LGsekara1/Multi-channel-RF-level-detector/README.md

# Multilevel RF Power Detector
**Dual-Band 433 MHz / 915 MHz RF Presence Indicator**

---

## General Description

The **Multilevel RF Power Detector** is a compact dual-band RF sensing device designed to detect and visually indicate the relative power of radio-frequency signals in the **433 MHz** and **915 MHz** ISM bands. The system employs band-pass filtering, low-noise amplification, and logarithmic detection to provide reliable RF presence indication using a multi-level LED display.

The device is intended for educational, laboratory, and experimental RF applications where quick visual feedback is required without the use of complex RF measurement equipment.

---

## Key Features

- Dual-band RF detection: 433 MHz and 915 MHz
- Logarithmic RF power detection
- Multi-level LED signal strength indication
- RF-optimized PCB layout
- Single DC supply operation
- Compact and portable design

---

## Applications

- ISM band signal monitoring
- RF laboratory demonstrations
- Educational RF experiments
- RF activity detection
- Wireless system debugging

---

## Functional Block Diagram

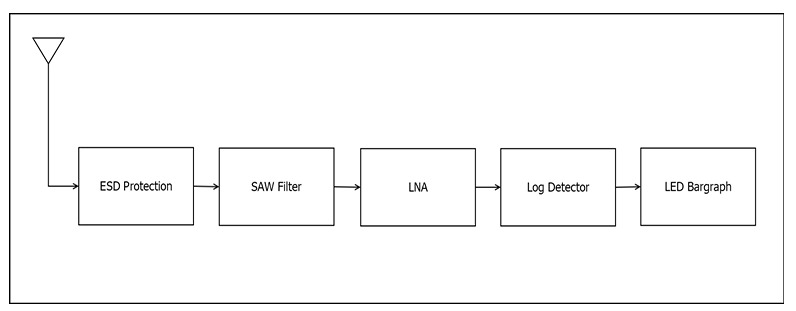
[picture p1: media/schematic_page18.jpg]
Block Diagram


---

## Electrical Characteristics

| Parameter | Typical Value |
|---|---|
| Supported Frequency Bands | 433 MHz, 915 MHz |
| Input Impedance | 50 Ω |
| LNA Gain | 433 MHz: 20.3 dB<br>915 MHz: 17.9 dB |
| Noise Figure | 433 MHz: 2.3 dB<br>915 MHz: 2.8 dB |
| Supply Voltage (Nominal) | 9 V |
| Supply Current | 200 mA |

---

## LED Signal Indication

| LED Status | RF Power Level (Relative) |
|---|---|
| 1 LED ON | Very Low |
| 2–3 LEDs ON | Low to Medium |
| 4–5 LEDs ON | Medium to High |
| All LEDs ON | High RF Power |

---

## Power Supply

- Single DC supply operation
- On-board voltage regulation

---

## Mechanical Information

| Parameter | Specification |
|---|---|
| PCB Dimensions | 126.37 mm × 129 mm |
| Antenna Connector | SMA Edge-Mount |
| Enclosure | Custom Enclosure |

---

## Mechanical Drawings

**Mechanical Drawing – Page 1**  
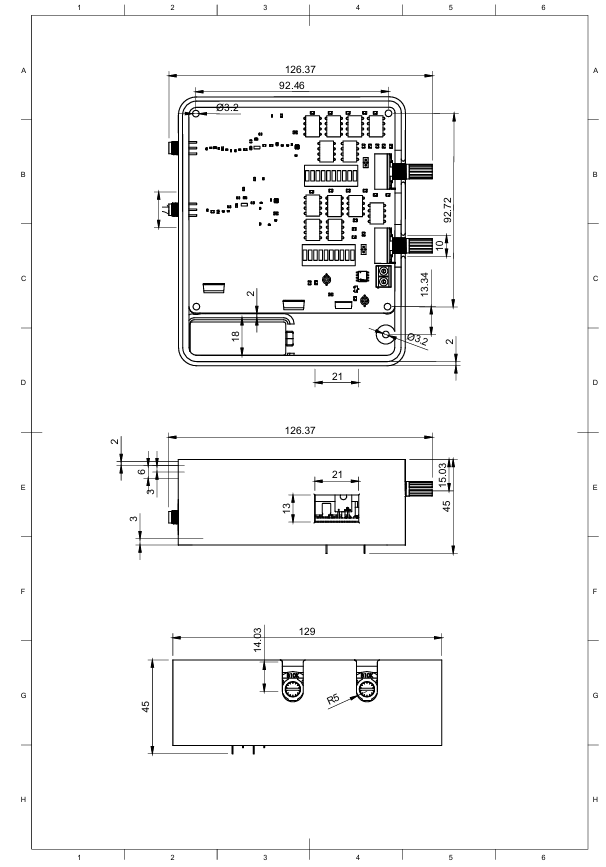
[picture p2: media/AnalogProject-page1.png]
Mechanical Drawing Page 1


**Mechanical Drawing – Page 2 (Assembly Views)**  
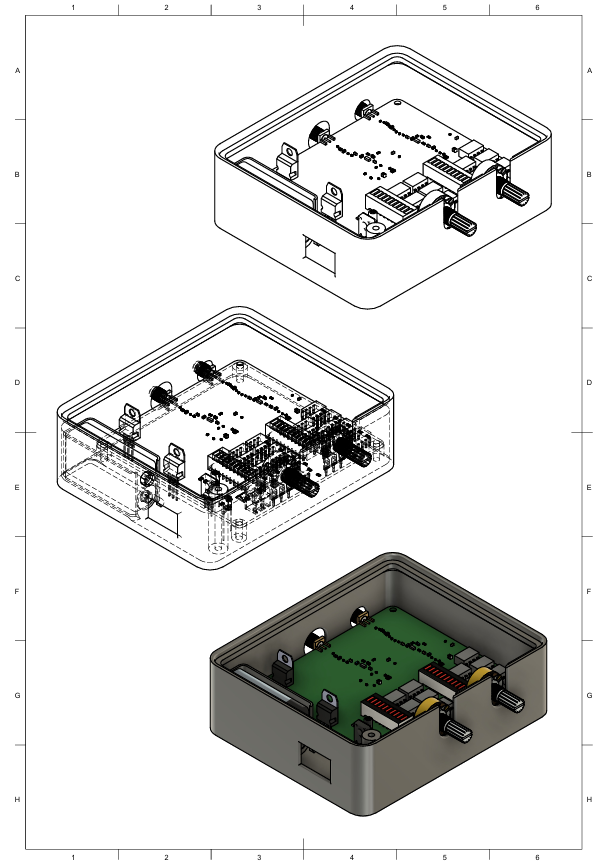
[picture p3: media/AnalogProject-page2.png]
Mechanical Drawing Page 2


---

## Schematics

### 433 MHz Section
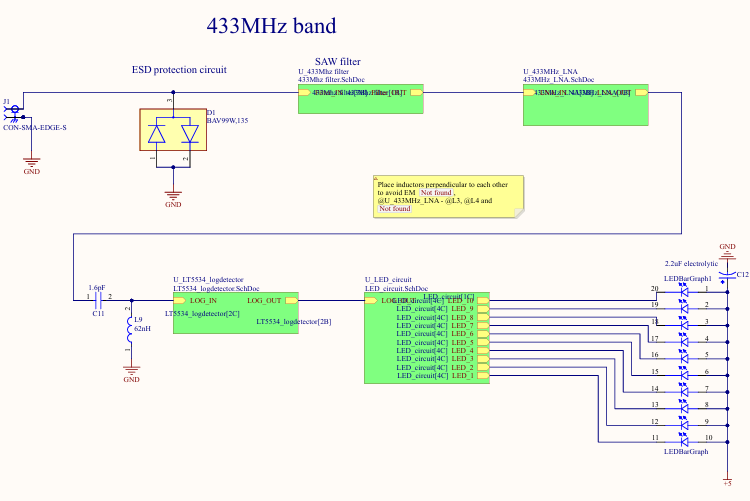
[picture p4: media/schematic_page1.png]
433 MHz Schematic


### 433 MHz LNA Design
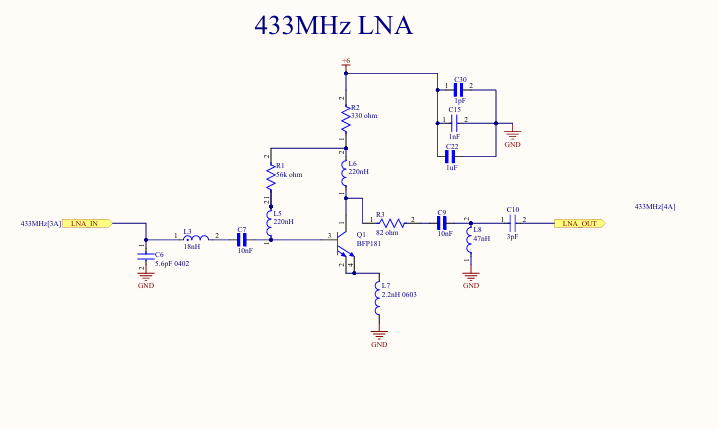
[picture p5: media/schematic_page2.png]
433 MHz LNA


### LED Driver Circuit
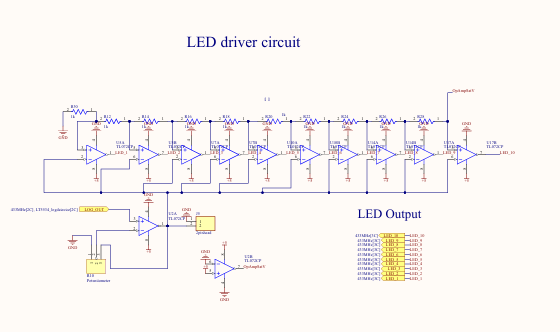
[picture p6: media/schematic_page3.png]
LED Driver


### Log Detector Circuit
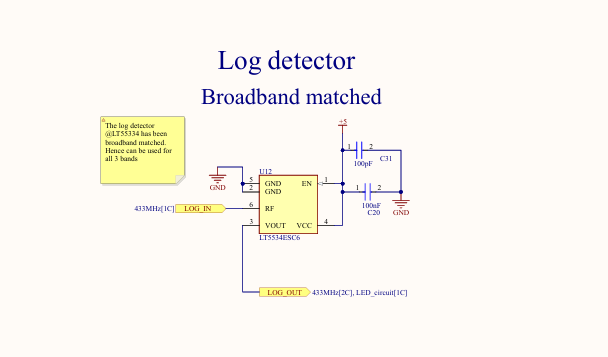
[picture p7: media/schematic_page4.png]
Log Detector


### 433 MHz Band-Pass Filter
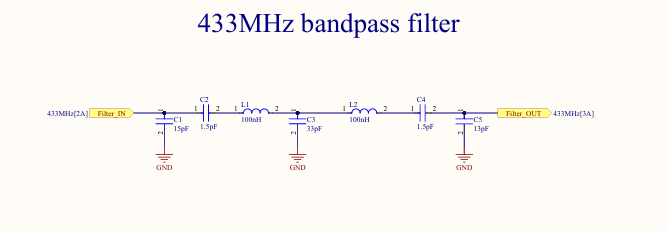
[picture p8: media/schematic_page5.png]
433 MHz BPF


### 915 MHz Section
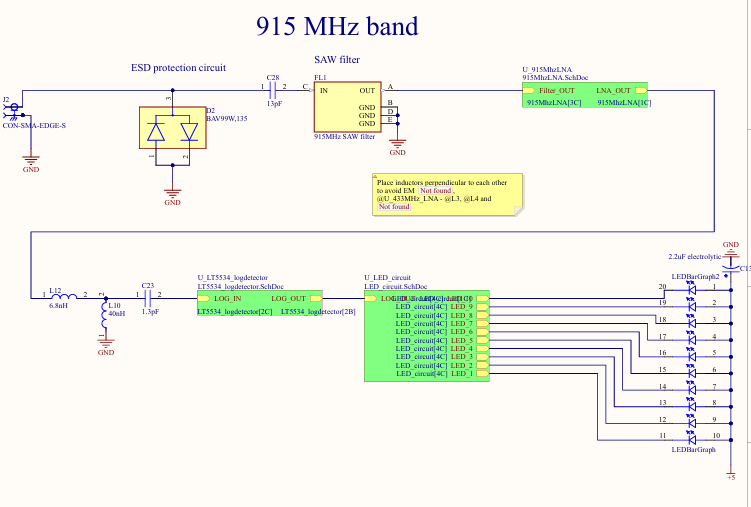
[picture p9: media/schematic_page6.png]
915 MHz Schematic


### 915 MHz LNA Design
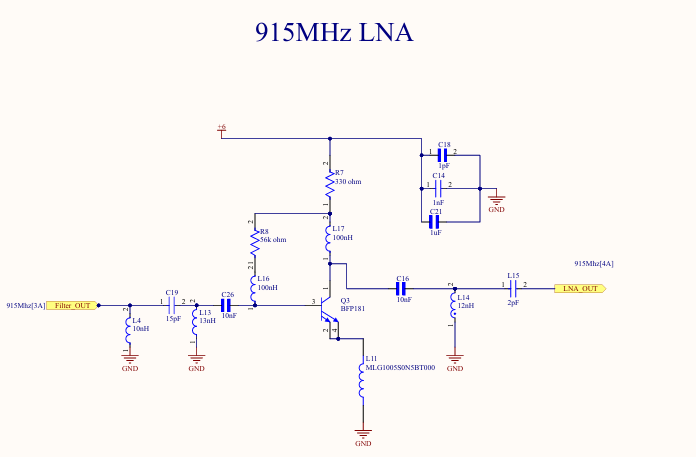
[picture p10: media/schematic_page7.png]
915 MHz LNA


### Power Supply Design
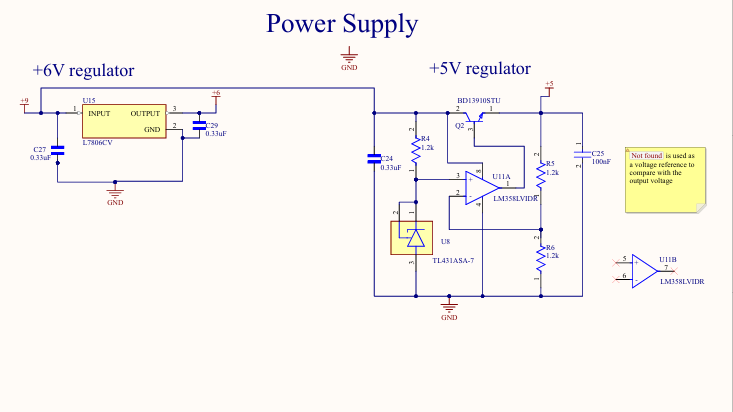
[picture p11: media/schematic_page8.png]
Power Supply


The power supply contains a 5V and 6V stable power supply. The 6V power supply being a 7806 regulator IC as the LNA requires a firm supply voltage. And the 5V supply was designed with a series transitor with a feedback with a TL431 as the reference voltage. This formation was selected because, the negative feedback maintains a relatively stable output of 5V and heat generation is minimum due to less current through series resistor in input branch.

---

## PCB Layout

### Top Layer
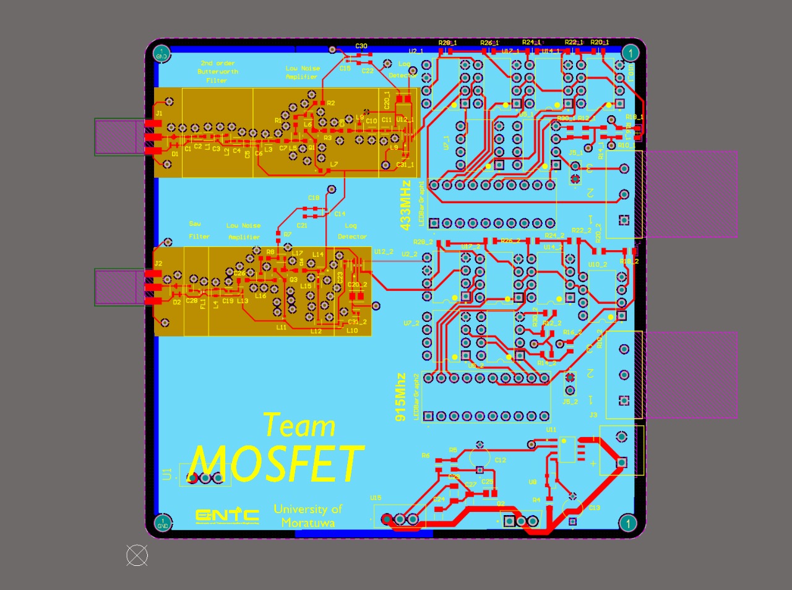
[picture p12: media/schematic_page9.jpg]
Top Layer


### RF Ground Layer (Layer 2)
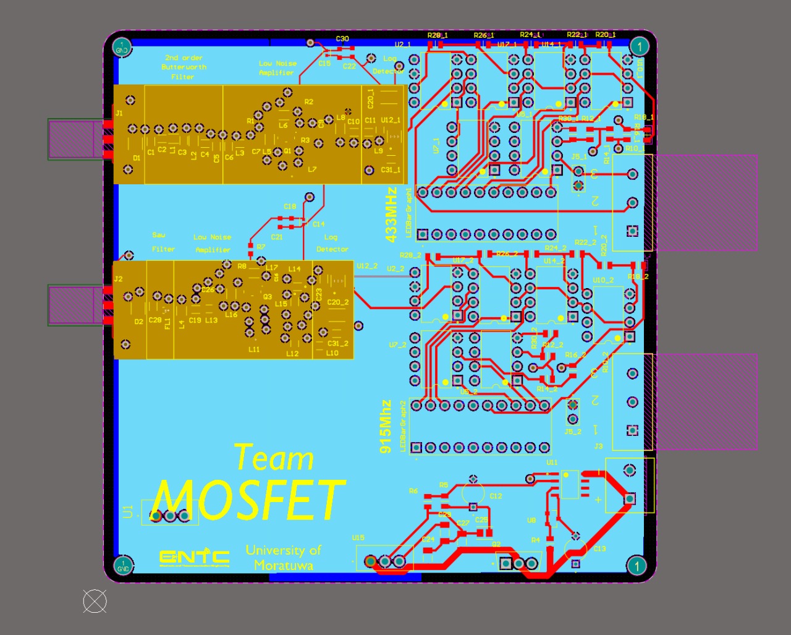
[picture p13: media/schematic_page14.jpg]
RF GND Layer


### PCB Ground Layer (Layer 3)
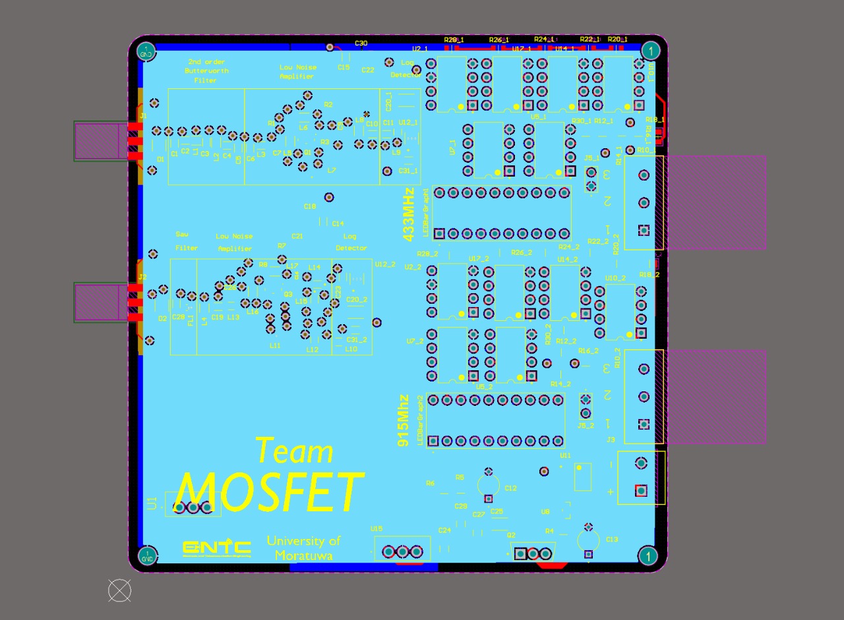
[picture p14: media/schematic_page10.jpg]
PCB GND Layer


### Bottom Layer
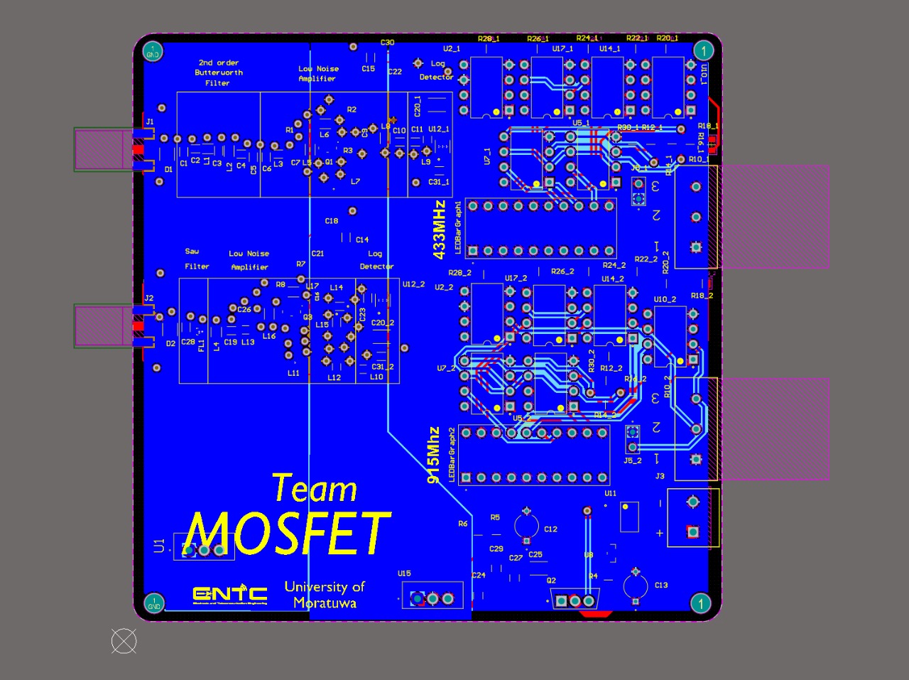
[picture p15: media/schematic_page11.jpg]
Bottom Layer


### PCB Stack-Up
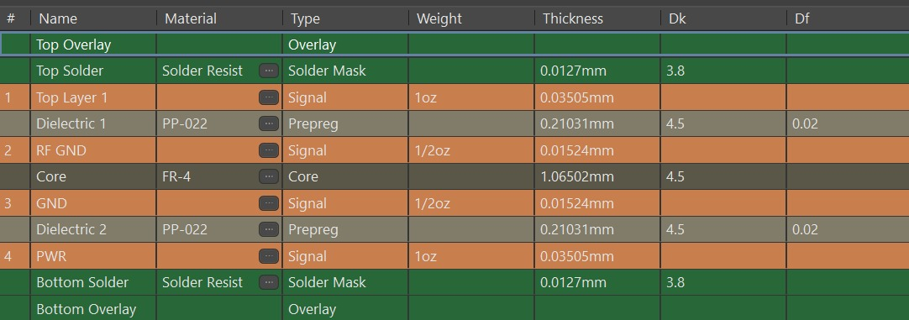
[picture p16: media/schematic_page12.jpg]
PCB Stackup


### 3D PCB View
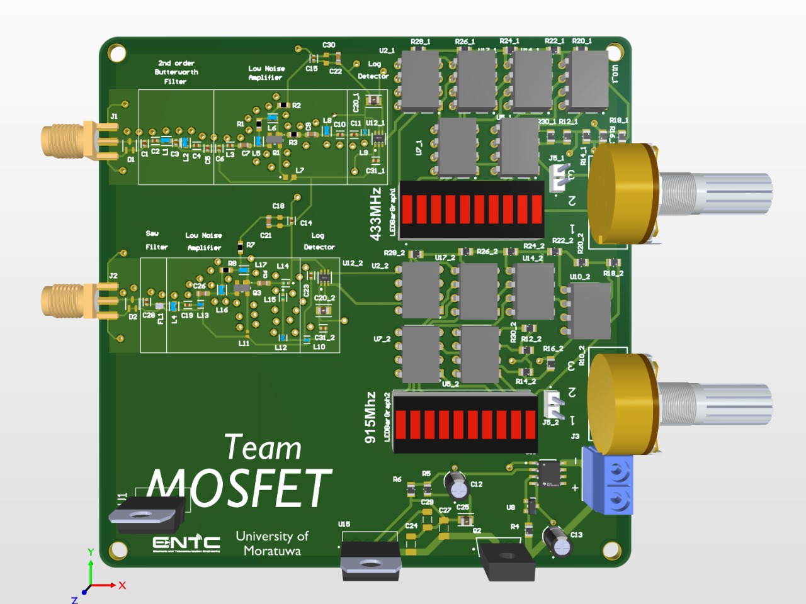
[picture p17: media/schematic_page13.jpg]
3D View


---

## Frequency Response

### 433 MHz Band
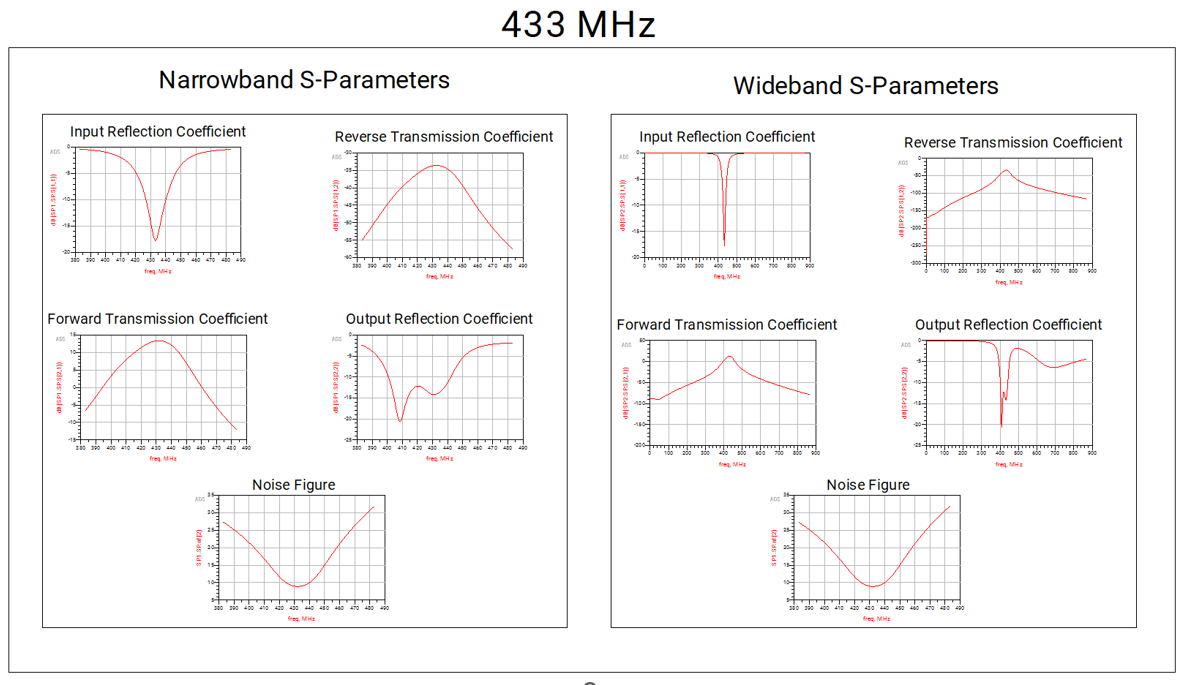
[picture p18: media/schematic_page15.png]
433 MHz Response


### 915 MHz Band
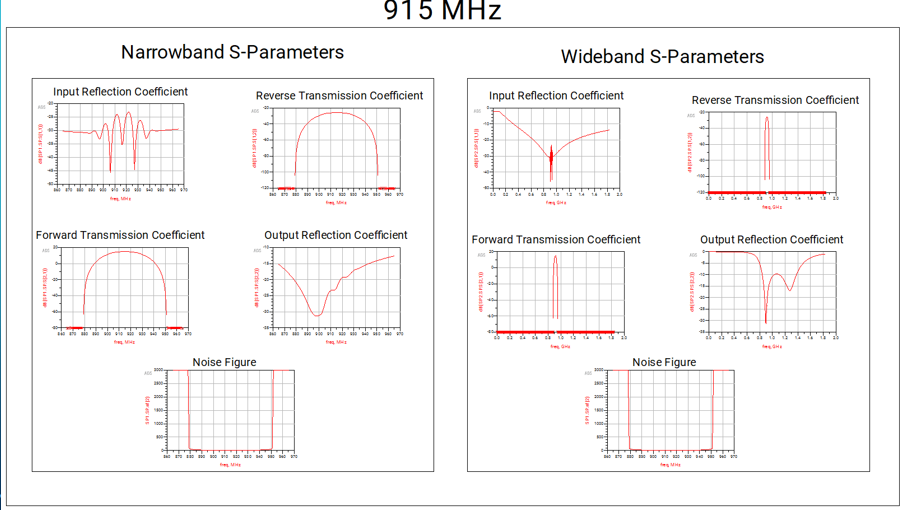
[picture p19: media/schematic_page16.png]
915 MHz Response


---

## Final Product

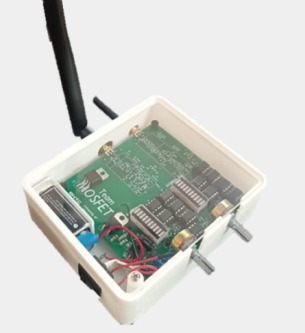
[picture p20: media/schematic_page17.jpg]
Final Product


---

## Team MOSFET
The project is developed and maintained by;
  1. Lakindu Gunasekara [@LGsekara1](https://github.com/LGsekara1)
  2. Sithum Peiris [@angstrom10](https://github.com/angstrom10)
  3. Hiruna Kariyawasam [@HirunaK](https://github.com/HirunaK)
  4. Chathuka Elapatha [@Chippy1520](https://github.com/Chippy1520)

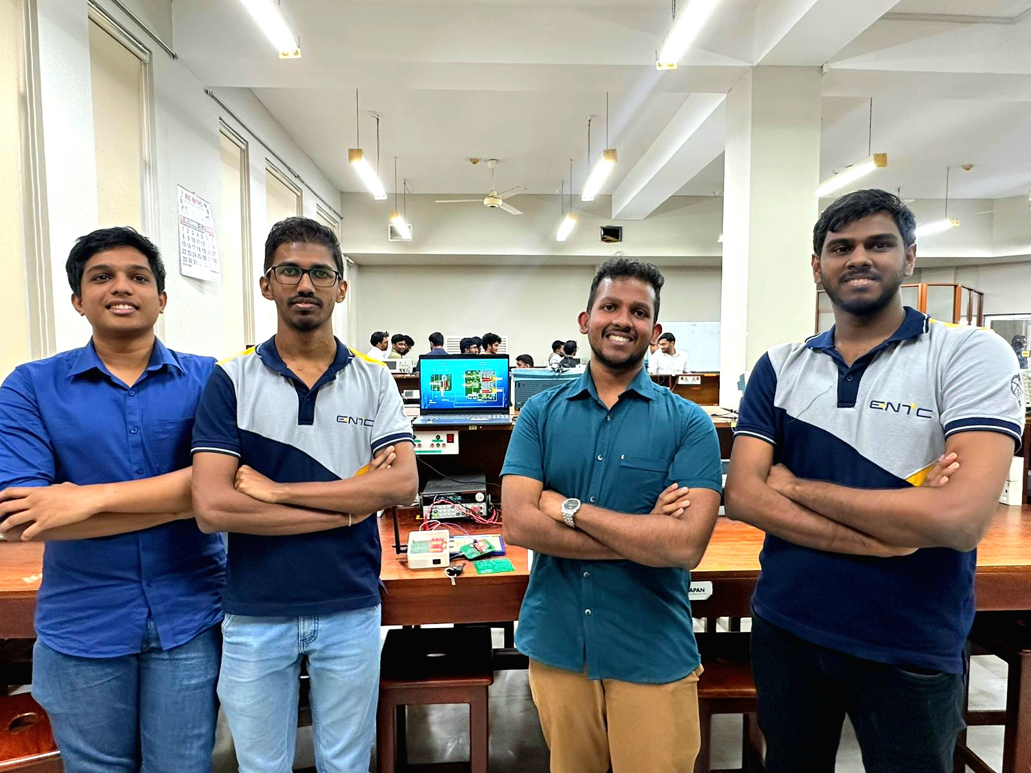
[picture p21: media/Team.jpg]
Team


## Handling and Precautions

- Device contains ESD-sensitive RF components
- Avoid hot-plugging the antenna
- Do not exceed the maximum supply voltage
- Use only matched SMA antennas

---

## Disclaimer

This product is intended for educational and experimental use only. It is not a calibrated RF power measurement instrument. Specifications are subject to change without notice.

---

**Department of Electronic & Telecommunication Engineering**  
**University of Moratuwa, Sri Lanka**
