LGsekara1/Multi-channel-RF-level-detector/media/433LNA_sim.png

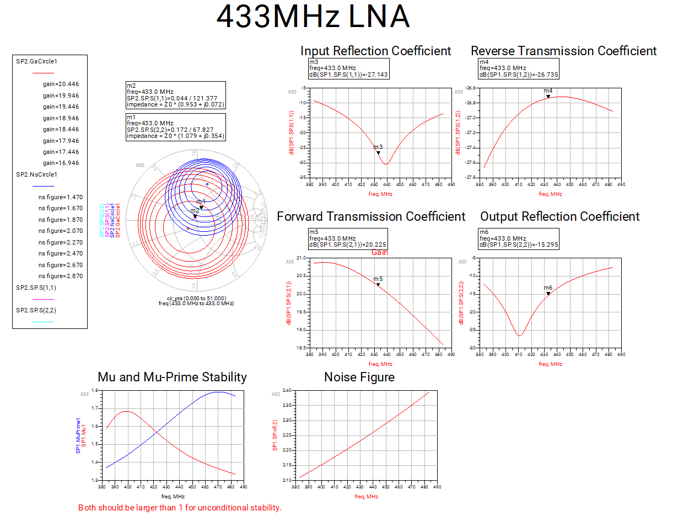
media/433LNA_sim.png
