LGsekara1/Multi-channel-RF-level-detector/media/433MHz LC filter.png

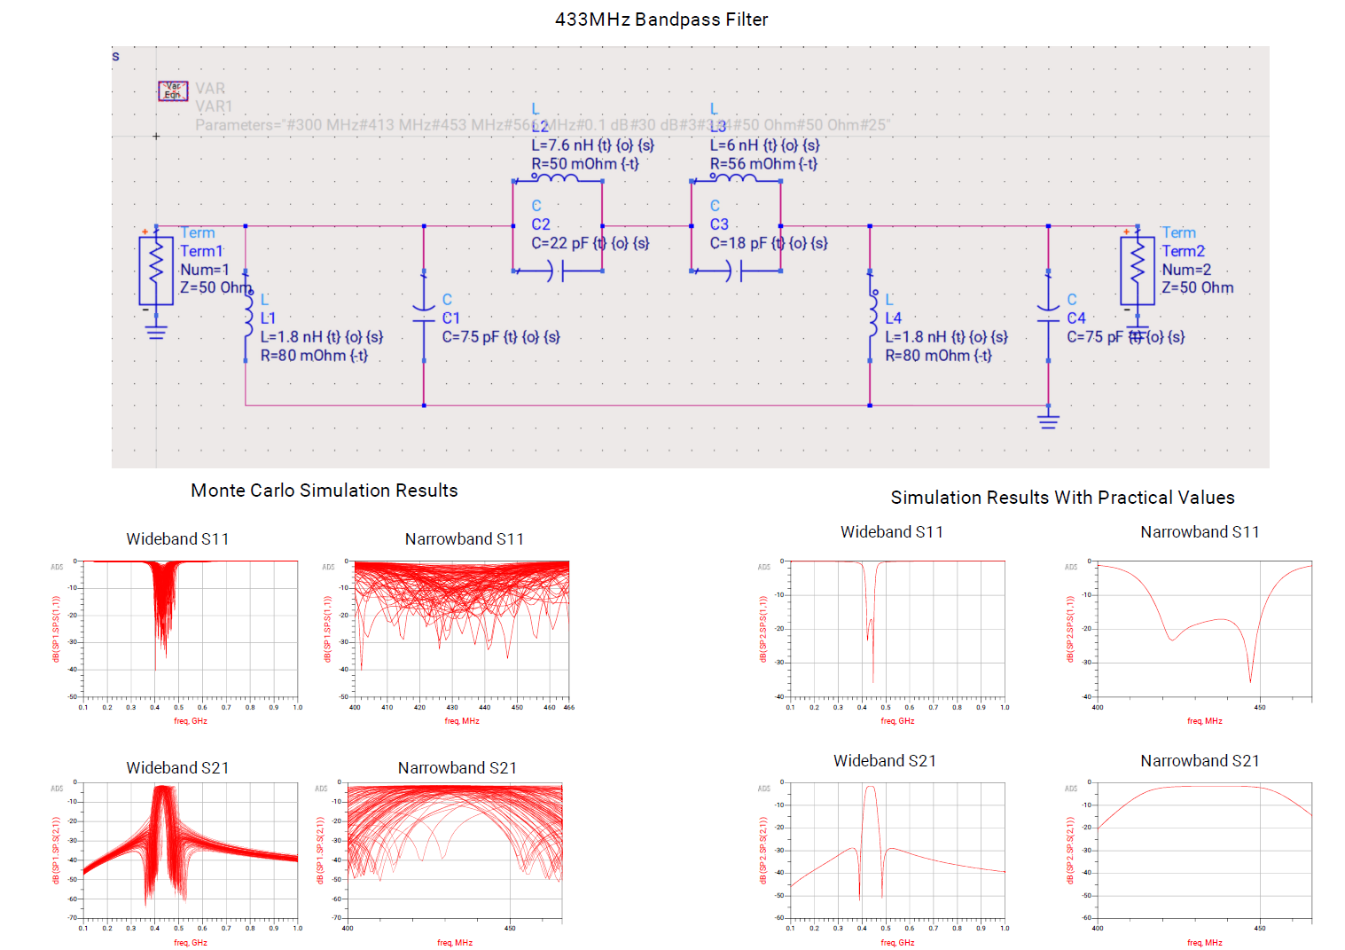
media/433MHz LC filter.png
