LGsekara1/Multi-channel-RF-level-detector/media/915LNA_Sim.png

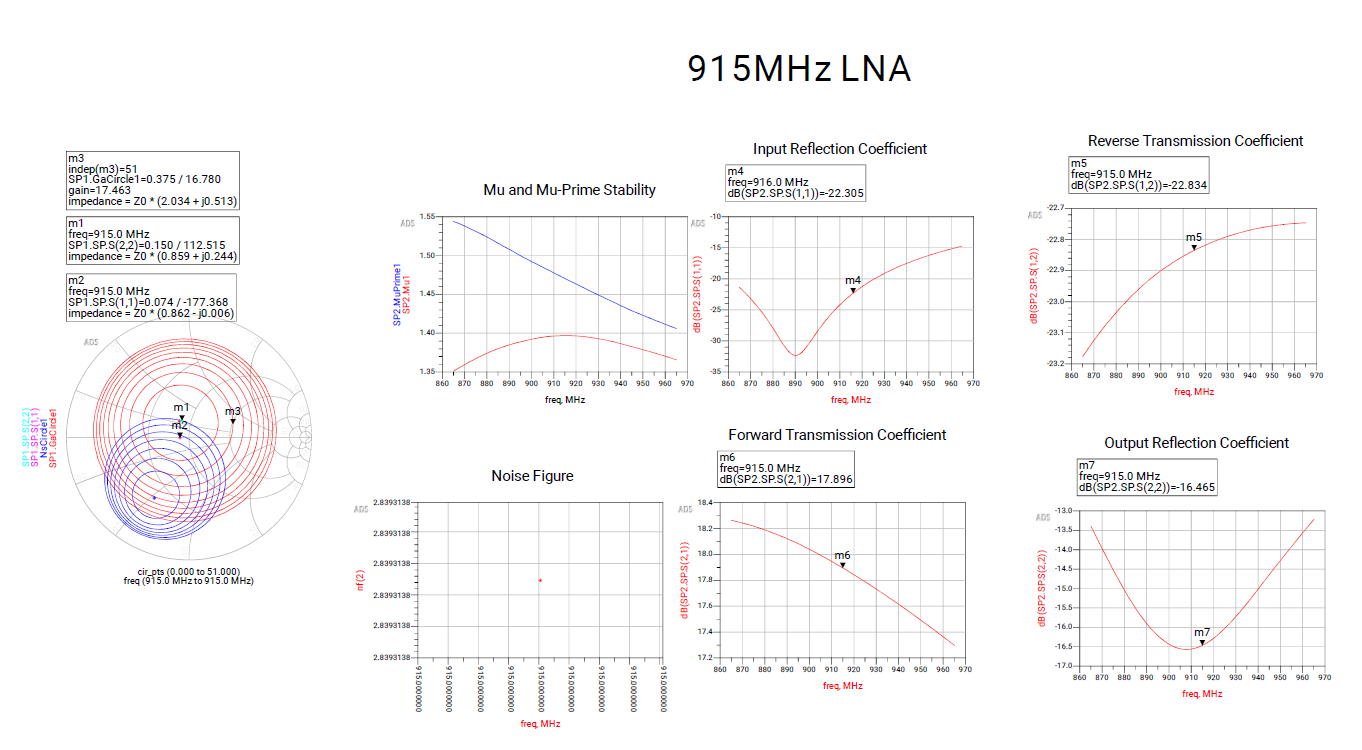
media/915LNA_Sim.png
