LGsekara1/Multi-channel-RF-level-detector/media/CurrentDesign_Response.png

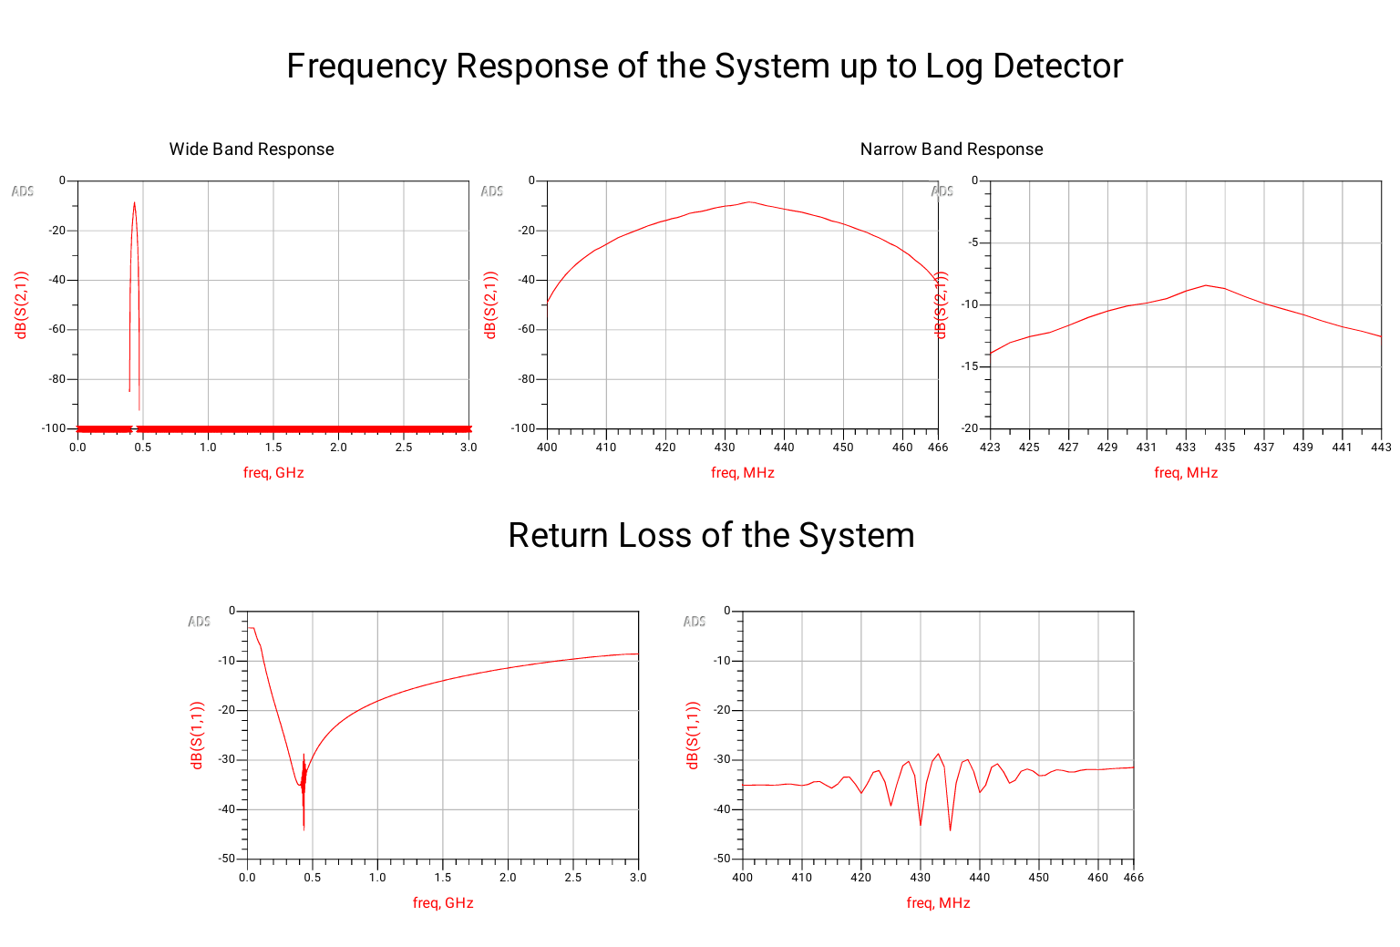
media/CurrentDesign_Response.png
