LGsekara1/Multi-channel-RF-level-detector/media/enclosure.jpeg

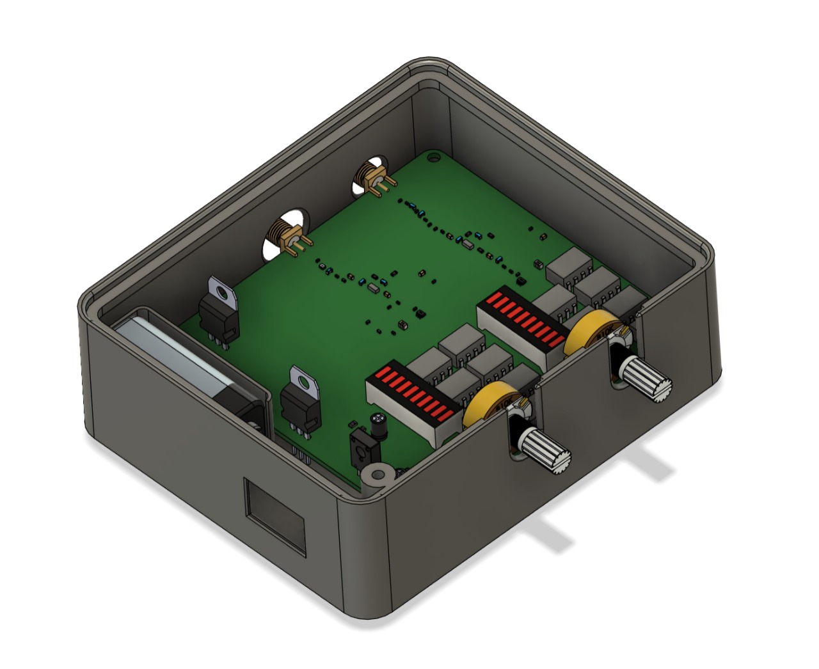
media/enclosure.jpeg
