LGsekara1/Multi-channel-RF-level-detector/media/FinalPCB.png

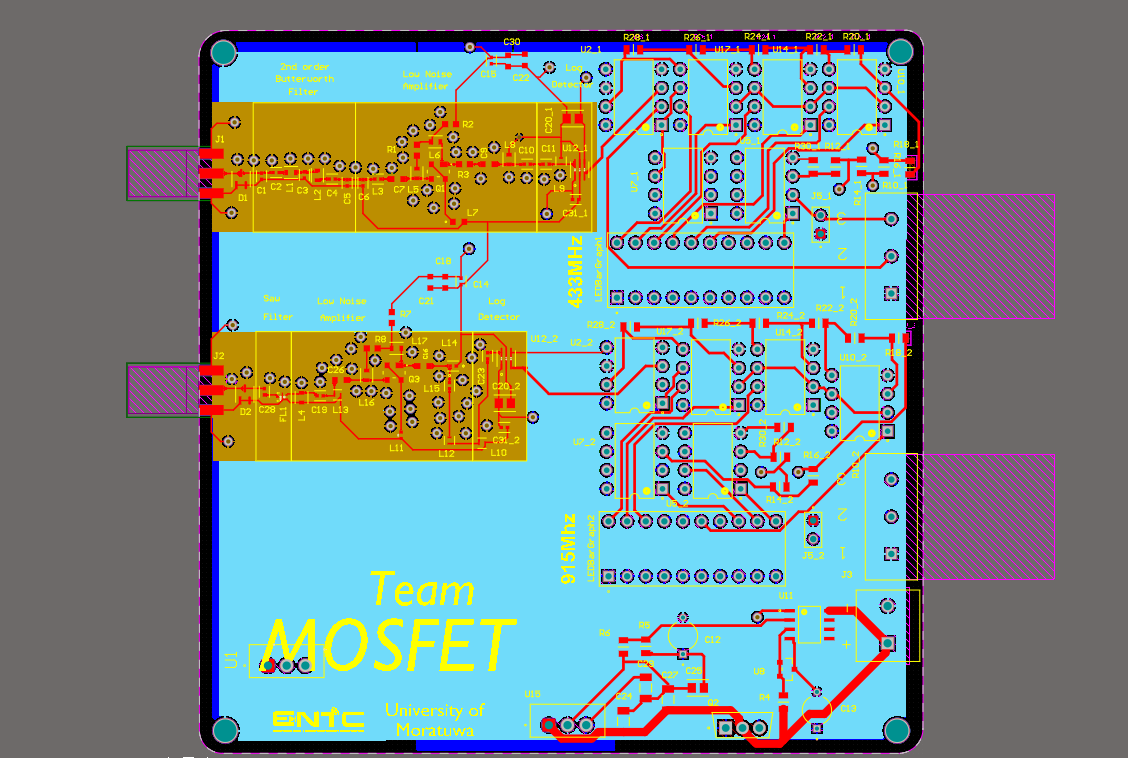
media/FinalPCB.png
