LGsekara1/Multi-channel-RF-level-detector/media/LNA915.jpeg

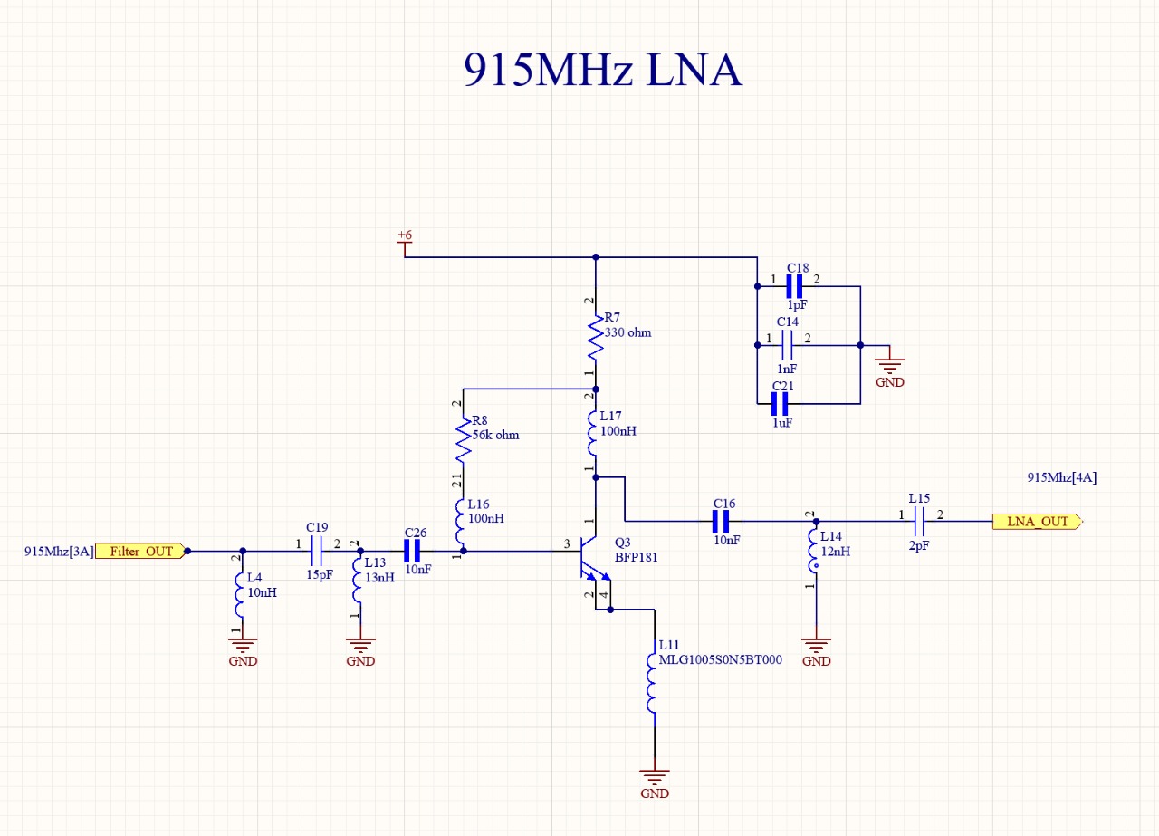
media/LNA915.jpeg
