LGsekara1/Multi-channel-RF-level-detector/media/logdetector_LTSpice.jpg

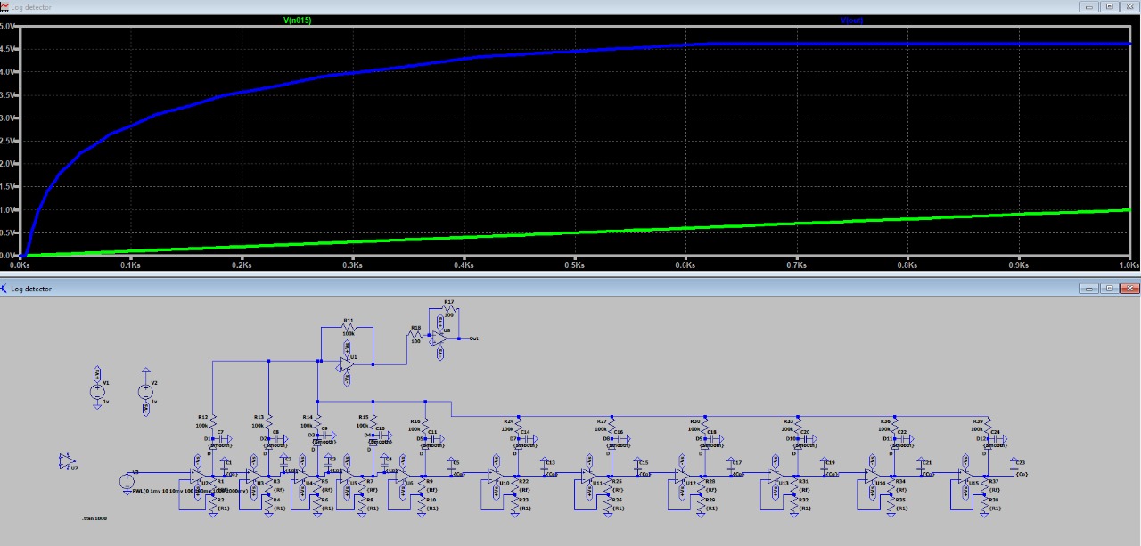
media/logdetector_LTSpice.jpg
