LGsekara1/Multi-channel-RF-level-detector/media/PCB 3D.png

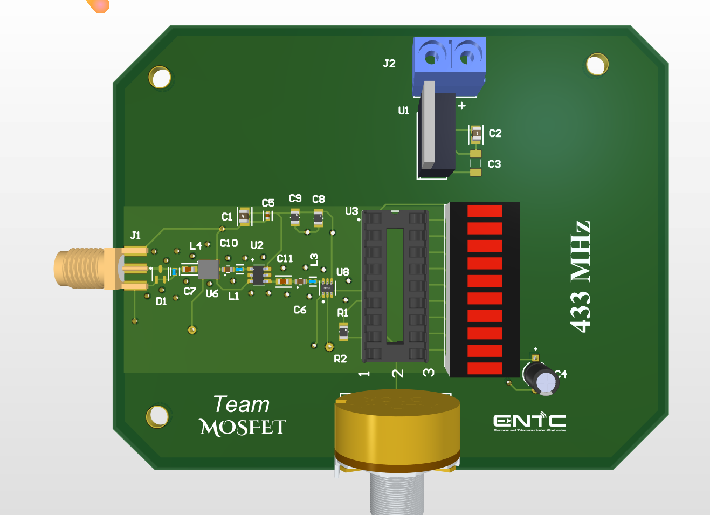
media/PCB 3D.png
