LGsekara1/Multi-channel-RF-level-detector/media/PCB_433MHz.png

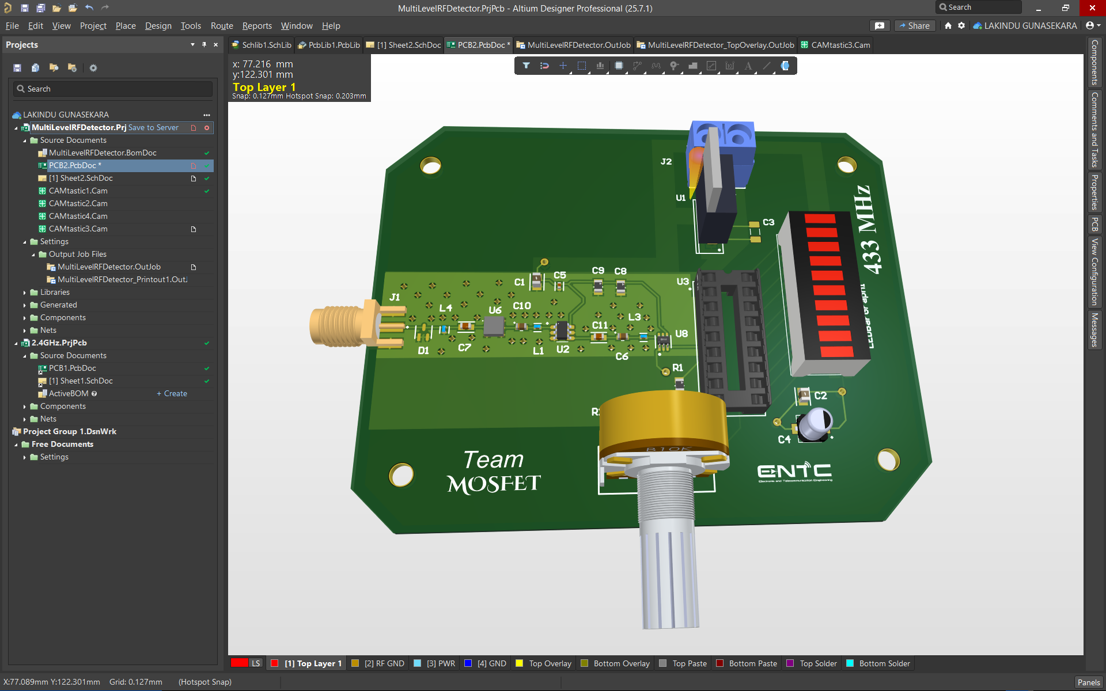
media/PCB_433MHz.png
