LGsekara1/Multi-channel-RF-level-detector/media/RF layer PCB.png

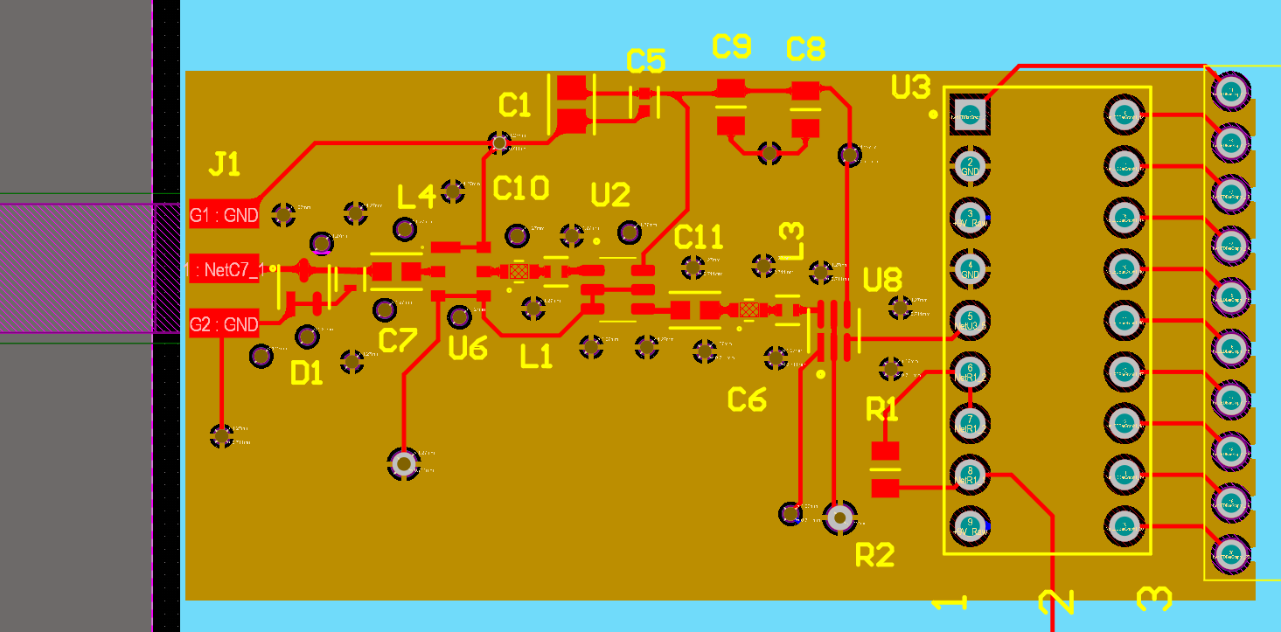
media/RF layer PCB.png
