LGsekara1/Multi-channel-RF-level-detector/media/RF trace length.jpg

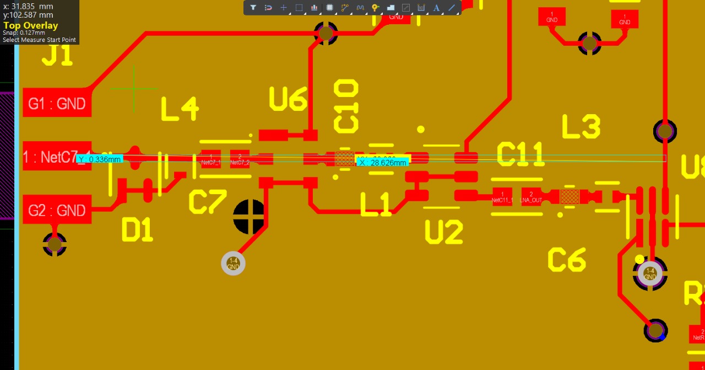
media/RF trace length.jpg
