LGsekara1/Multi-channel-RF-level-detector/media/RF trace.png

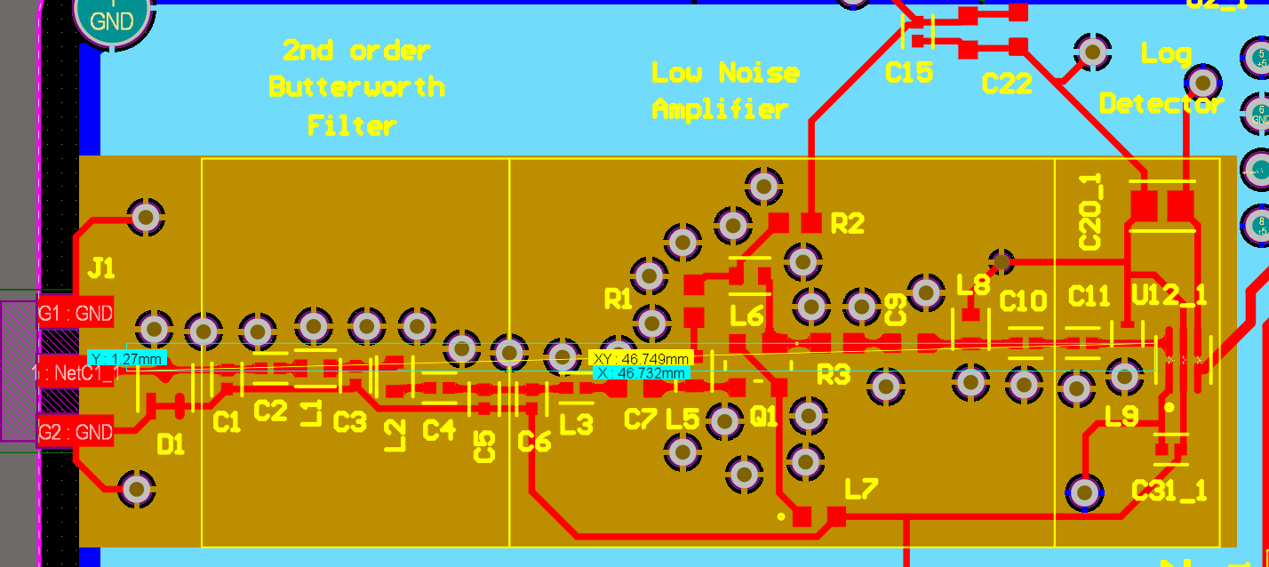
media/RF trace.png
