LGsekara1/Multi-channel-RF-level-detector/media/AnalogProject.pdf

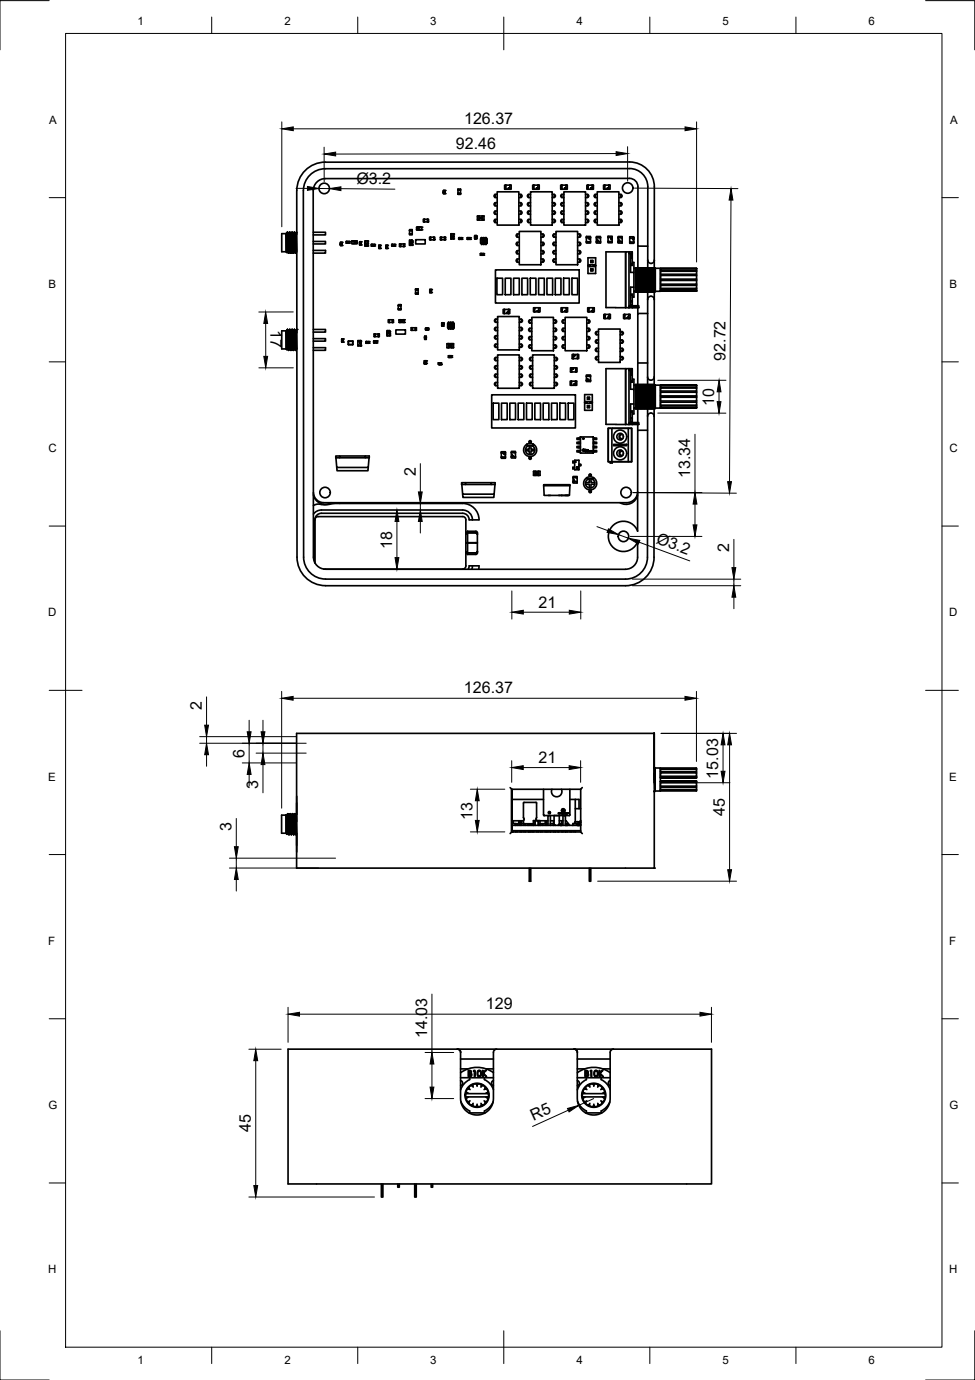
[picture p53: page 1]

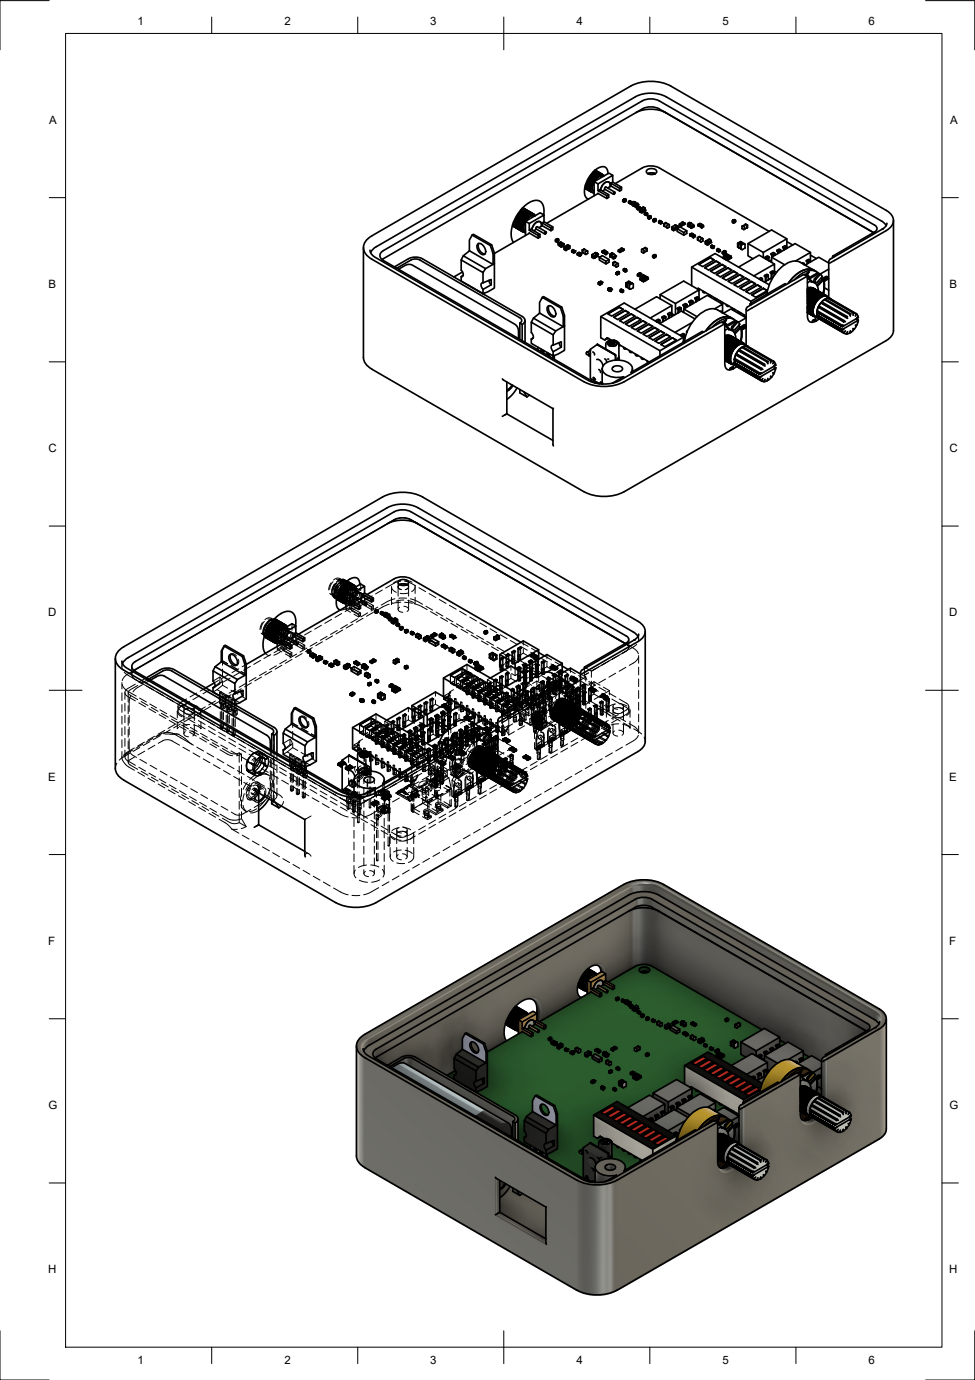
[picture p54: page 2]
6 ABCDEFGH; ABCDEFGH
