LGsekara1/Multi-channel-RF-level-detector/components/LM3915/LM3914/LM3914_Test.asc

D1a: LED; NSCW100
D1b: LED; NSCW100
D2a: LED; NSCW100
D2b: LED; NSCW100
D9a: LED; NSCW100
D9b: LED; NSCW100
D10a: LED; NSCW100
D10b: LED; NSCW100
R1a: res; 1k2
R1b: res; 1k8
R2a: res; 1k2
R2b: res; 8k2
R3a: res; 22k
U1: LM3914
U2: LM3914
V1: voltage; 2
V2: voltage; 12
V3: voltage; PULSE(2 8 0 1)
Vled: voltage; 5
Named nets: 0, In, hi1, lo1, V+, hi2, V-, lo2
.tran 0 1 1m uic
LM3914 Test Jig
Sw1
Sw2
Sw3
